cooked/Nucleololu64/README.md

# Nucleololu64
3D printer shield for the STM32 Nucleo 64 board

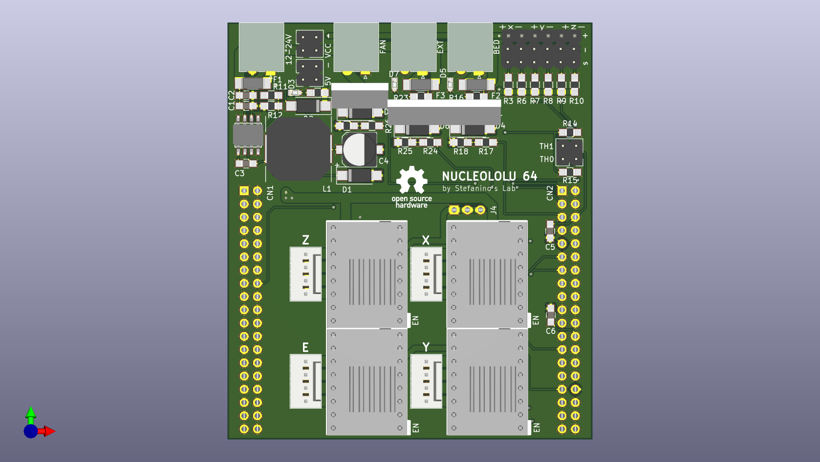
[picture p1: img/Nucleololu64_F.png]
Front
  
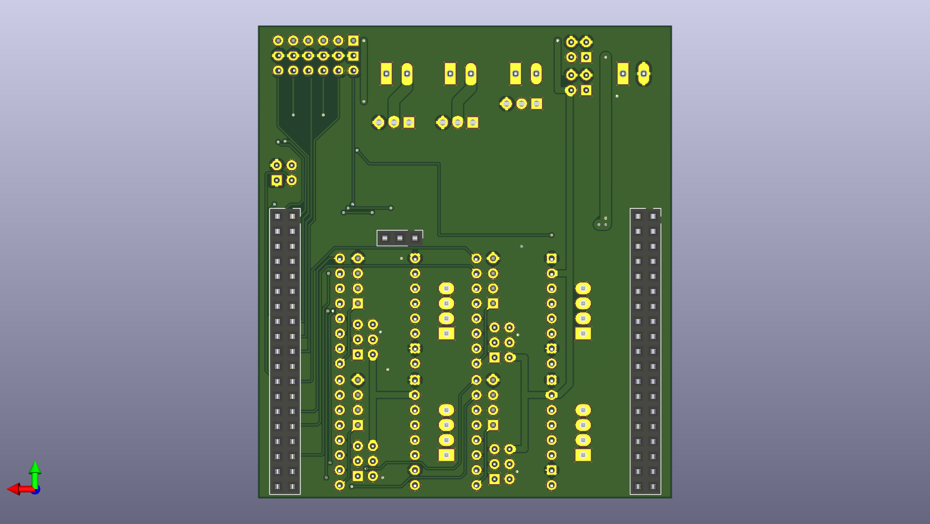
[picture p2: img/Nucleololu64_B.png]
Back
