cooked/Nucleololu64/Footprints/Pololu_Stick_Complete.step

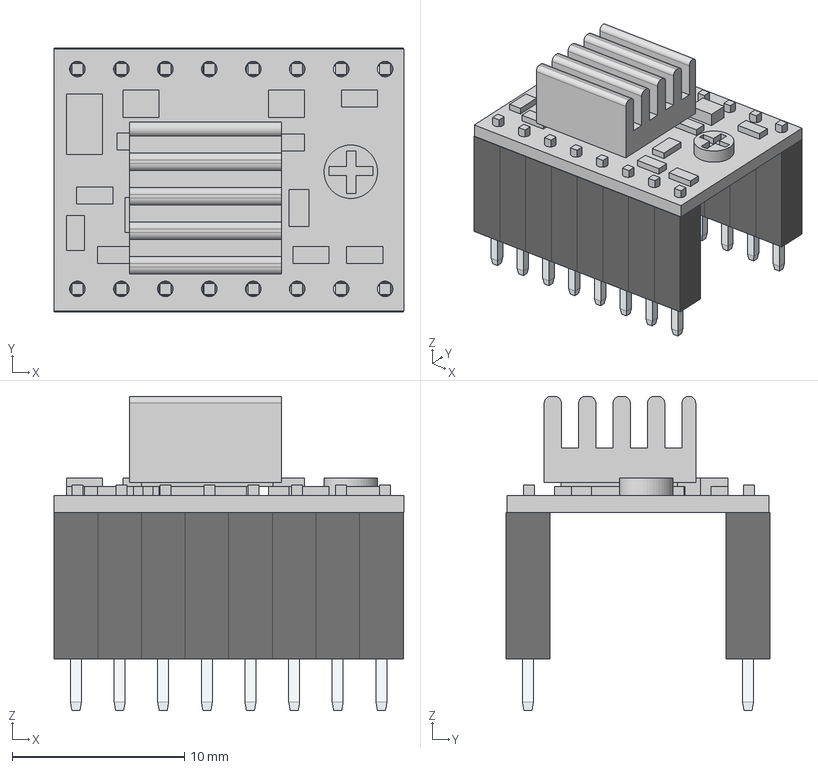
[picture p3: CAD file, 2018-03-17]
Footprints/Pololu_Stick_Complete.step
20.3 x 15.3 x 18.3 mm
Pololu A4899
2.54X8_pinheader_female
2.54X8_pinheader_female v1(Mirror)
