cooked/Nucleololu64/Nucleololu64.kicad_pcb

## KiCad design Nucleololu64.kicad_pcb (2018-03-17)

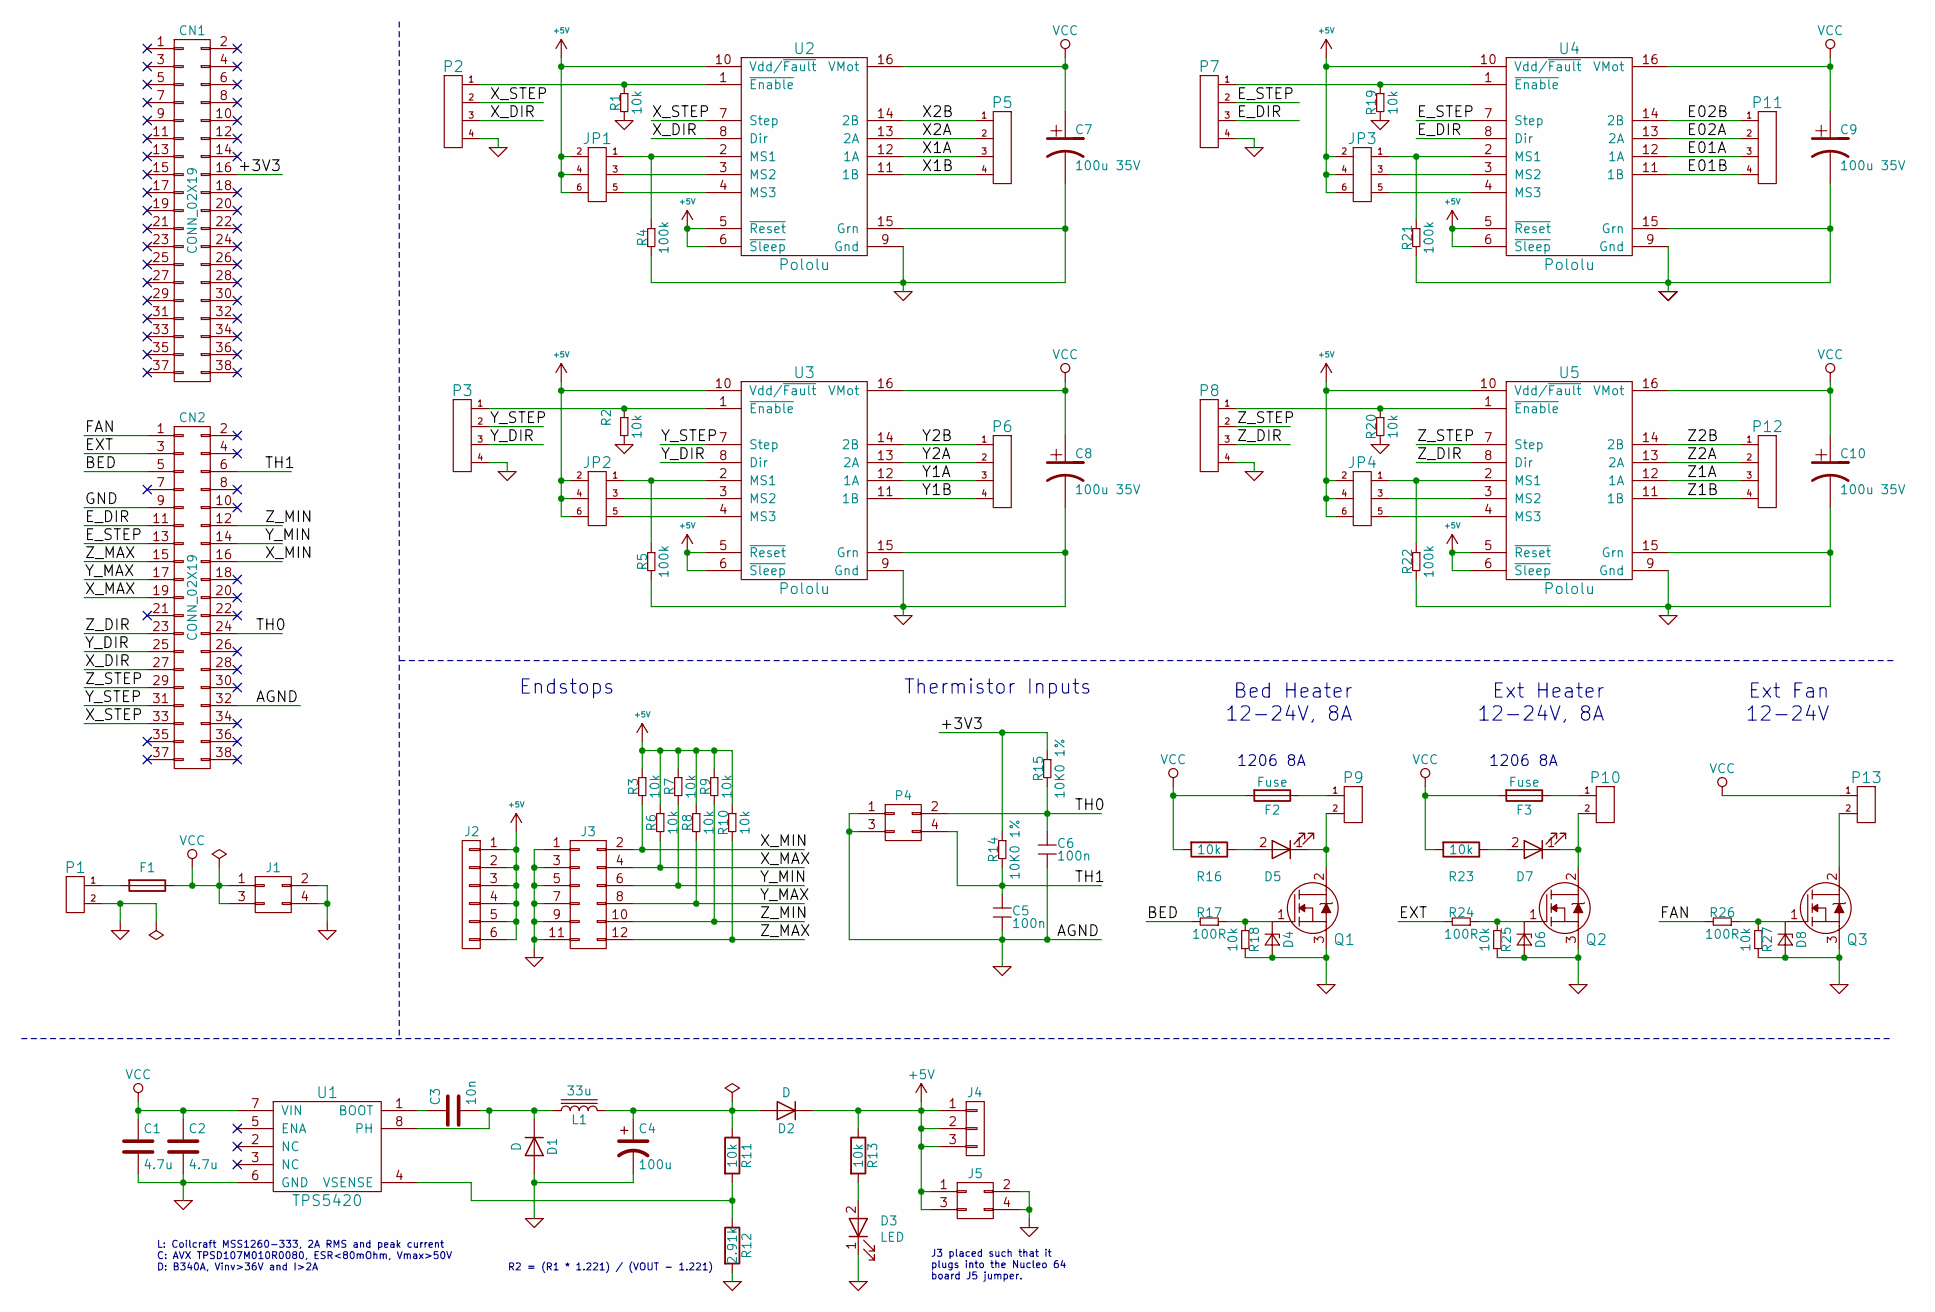
[picture p4: schematic Nucleololu64.sch]

Parts:
C1, C2: 4.7u; C_0805_HandSoldering
C3: 10n; C_0805_HandSoldering
C4: 100u; CP_Elec_6.3x7.7
C5, C6: 100n; C_0805_HandSoldering; PartNo GRM188R71C104KA01D
C7, C8, C9, C10: 100u 35V; CP_Elec_6.3x7.7
CN1, CN2: CONN_02X19; Socket_Strip_Straight_2x19_Pitch2.54mm
D1, D2: D; D_SMA_Handsoldering
D3, D5, D7: LED; LED_0603
D4, D6, D8: D_Zener_Small; D_SMA_Handsoldering
F1, F2, F3: Fuse; Fuse_SMD1206_HandSoldering
J1, J5: CONN_02X02; Pin_Header_Straight_2x02_Pitch2.54mm
J2: CONN_01X06; Pin_Header_Straight_1x06_Pitch2.54mm
J3: CONN_02X06; Pin_Header_Straight_2x06_Pitch2.54mm
J4: CONN_01X03; Socket_Strip_Straight_1x03_Pitch2.54mm
JP1, JP2, JP3, JP4: HEADER_3X2; Pin_Header_Straight_2x03_Pitch2.54mm
L1: 33u; L_12x12mm_h6mm
P1: PT_2,5-2-5,0-H; PhoenixContact_MC-G_02x3.50mm_Angled
P2, P3, P7, P8: KK-2.54-4W; Pin_Header_Straight_1x04_Pitch2.54mm; PartNo 22-23-2041
P4: CONN_02X02; Pin_Header_Straight_2x02_Pitch2.54mm
P5, P6, P11, P12: KK-2.54-4W; Molex_KK-6410-04_04x2.54mm_Straight
P9, P10: PT_2,5-2-5,0-H; PhoenixContact_MC-G_02x3.50mm_Angled; PartNo 1935776
P13: PT_1,5-2-3,5-H; PhoenixContact_MC-G_02x3.50mm_Angled; PartNo 1984617
Q1, Q2, Q3: IRLB8743PBF; TO-220-3_Vertical
R1, R3, R6, R7, R8, R10, R11, R13, R16, R19, R20, R23: 10k; R_0805_HandSoldering
R2: 10k; R_0805_HandSoldering; PartNo RMCF0603FT100K
R4, R5, R21, R22: 100k; R_0805_HandSoldering
R9: 10k; R_0805_HandSoldering; PartNo RMCF0603FT10K0
R12: 2.91k; R_0805_HandSoldering
R14, R15: 10K0 1%; R_0805_HandSoldering
R17, R24, R26: 100R; R_0805_HandSoldering; PartNo RMCF0603FT220R
R18, R25, R27: 10k; R_0805_HandSoldering; PartNo RMCF0603FT220R
U1: TPS5420; SOIC-8-N
U2: Pololu; Pololu_socket
U3, U4, U5: Pololu; Pololu_socket; PartNo DRV8825

Connections:
+5V: D2.1 (K), J2.1, J2.2, J2.3, J2.4, J2.5, J2.6, J4.1, J4.2, J4.3, J5.1, J5.3, JP1.2, JP1.4, JP1.6, JP2.2, JP2.4, JP2.6, JP3.2, JP3.4, JP3.6, JP4.2, JP4.4, JP4.6, R3.1, R6.1, R7.1, R8.1, R9.1, R10.1, R13.1, U2.5 (~Reset), U2.6 (~Sleep), U2.10 (Vdd/~Fault), U3.5 (~Reset), U3.6 (~Sleep), U3.10 (Vdd/~Fault), U4.5 (~Reset), U4.6 (~Sleep), U4.10 (Vdd/~Fault), U5.5 (~Reset), U5.6 (~Sleep), U5.10 (Vdd/~Fault); also elsewhere on the board
/+3V3: CN1.16, R14.1, R15.1
/BED: CN2.5, R17.2
/E01A: P11.3, U4.12 (1A)
/E01B: P11.4, U4.11 (1B)
/E02A: P11.2, U4.13 (2A)
/E02B: P11.1, U4.14 (2B)
/EXT: CN2.3, R24.2
/E_DIR: CN2.11, P7.3, U4.8 (Dir)
/E_STEP: CN2.13, P7.2, U4.7 (Step)
/FAN: CN2.1, R26.2
/TH0: C6.1, CN2.24, P4.2, R15.2
/TH1: C5.1, CN2.6, P4.4, R14.2
/X1A: P5.3, U2.12 (1A)
/X1B: P5.4, U2.11 (1B)
/X2A: P5.2, U2.13 (2A)
/X2B: P5.1, U2.14 (2B)
/X_DIR: CN2.27, P2.3, U2.8 (Dir)
/X_MAX: CN2.19, J3.4, R6.2
/X_MIN: CN2.16, J3.2, R3.2
/X_STEP: CN2.33, P2.2, U2.7 (Step)
/Y1A: P6.3, U3.12 (1A)
/Y1B: P6.4, U3.11 (1B)
/Y2A: P6.2, U3.13 (2A)
/Y2B: P6.1, U3.14 (2B)
/Y_DIR: CN2.25, P3.3, U3.8 (Dir)
/Y_MAX: CN2.17, J3.8, R8.2
/Y_MIN: CN2.14, J3.6, R7.2
/Y_STEP: CN2.31, P3.2, U3.7 (Step)
/Z1A: P12.3, U5.12 (1A)
/Z1B: P12.4, U5.11 (1B)
/Z2A: P12.2, U5.13 (2A)
/Z2B: P12.1, U5.14 (2B)
/Z_DIR: CN2.23, P8.3, U5.8 (Dir)
/Z_MAX: CN2.15, J3.12, R10.2
/Z_MIN: CN2.12, J3.10, R9.2
/Z_STEP: CN2.29, P8.2, U5.7 (Step)
GND: C1.2, C2.2, C4.2, C5.2, C6.2, C7.2, C8.2, C9.2, C10.2, CN2.9, CN2.32, D1.2 (A), D3.1 (K), D4.2 (A), D6.2 (A), D8.2 (A), J1.2, J1.4, J3.1, J3.3, J3.5, J3.7, J3.9, J3.11, J5.2, J5.4, P1.2, P2.4, P3.4, P4.1, P4.3, P7.4, P8.4, Q1.3, Q2.3, Q3.3, R1.2, R2.2, R4.2, R5.2, R12.2, R18.1, R19.2, R20.2, R21.2, R22.2, R25.1, R27.1, U1.6 (GND), U2.9 (Gnd), U2.15 (Grn), U3.9 (Gnd), U3.15 (Grn), U4.9 (Gnd), U4.15 (Grn), U5.9 (Gnd), U5.15 (Grn); also elsewhere on the board
unnamed: C3.1, U1.1 (BOOT)
unnamed: C3.2, D1.1 (K), L1.1, U1.8 (PH)
unnamed: C4.1, D2.2 (A), L1.2, R11.1
unnamed: D3.2 (A), R13.2
unnamed: D4.1 (K), Q1.1, R17.1, R18.2
unnamed 43: D5.1 (K), P9.2, Q1.2; also elsewhere on the board
unnamed: D5.2 (A), R16.1
unnamed: D6.1 (K), Q2.1, R24.1, R25.2
unnamed 46: D7.1 (K), P10.2, Q2.2; also elsewhere on the board
unnamed: D7.2 (A), R23.1
unnamed: D8.1 (K), Q3.1, R26.1, R27.2
unnamed 49: F1.2, P1.1; also elsewhere on the board
unnamed 50: F2.1, P9.1; also elsewhere on the board
unnamed 51: F3.1, P10.1; also elsewhere on the board
unnamed: JP1.1, R4.1, U2.2 (MS1)
unnamed: JP1.3, U2.3 (MS2)
unnamed: JP1.5, U2.4 (MS3)
unnamed: JP2.1, R5.1, U3.2 (MS1)
unnamed: JP2.3, U3.3 (MS2)
unnamed: JP2.5, U3.4 (MS3)
unnamed: JP3.1, R21.1, U4.2 (MS1)
unnamed: JP3.3, U4.3 (MS2)
unnamed: JP3.5, U4.4 (MS3)
unnamed: JP4.1, R22.1, U5.2 (MS1)
unnamed: JP4.3, U5.3 (MS2)
unnamed: JP4.5, U5.4 (MS3)
unnamed: P2.1, R1.1, U2.1 (~Enable)
unnamed: P3.1, R2.1, U3.1 (~Enable)
unnamed: P7.1, R19.1, U4.1 (~Enable)
unnamed: P8.1, R20.1, U5.1 (~Enable)
unnamed 68: P13.2, Q3.2; also elsewhere on the board
unnamed: R11.2, R12.1, U1.4 (VSENSE)
VCC: C1.1, C2.1, C7.1, C8.1, C9.1, C10.1, F1.1, F2.2, F3.2, J1.1, J1.3, P13.1, R16.2, R23.2, U1.7 (VIN), U2.16 (VMot), U3.16 (VMot), U4.16 (VMot), U5.16 (VMot); also elsewhere on the board

Notes on the sheet:
Endstops
Thermistor Inputs
Ext Heater 12-24V, 8A
Ext Fan 12-24V
1206 8A
R2 = (R1 * 1.221) / (VOUT - 1.221)
L: Coilcraft MSS1260-333, 2A RMS and peak current C: AVX TPSD107M010R0080, ESR<80mOhm, Vmax>50V D: B340A, Vinv>36V and I>2A
Bed Heater 12-24V, 8A
J3 placed such that it plugs into the Nucleo 64 board J5 jumper.

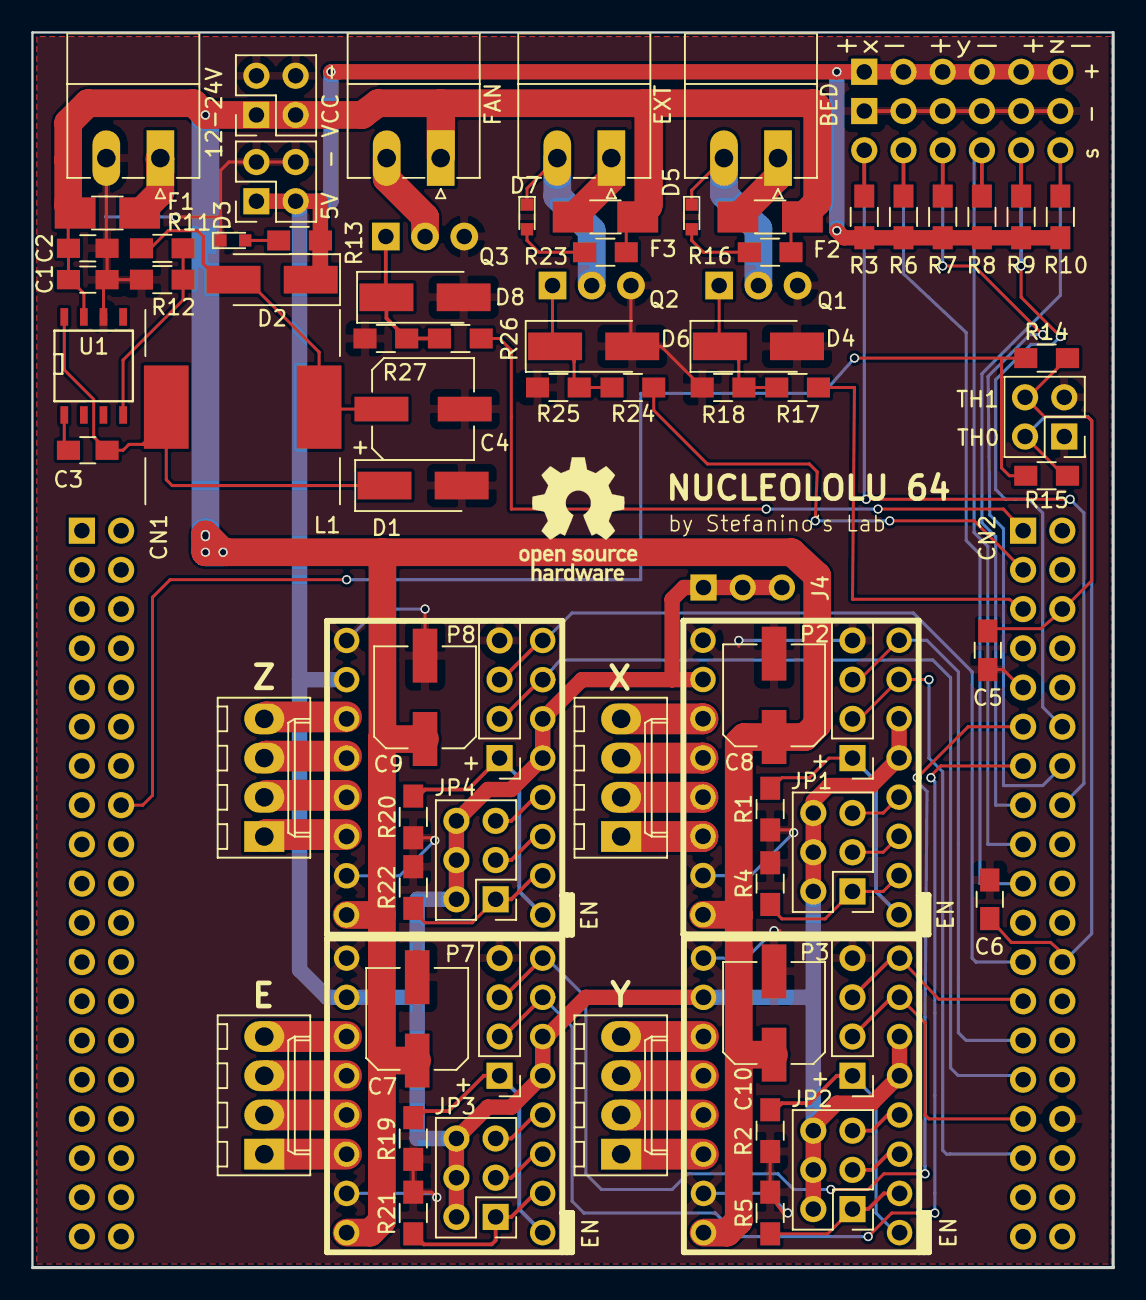
[picture p5: board Nucleololu64.kicad_pcb from above]

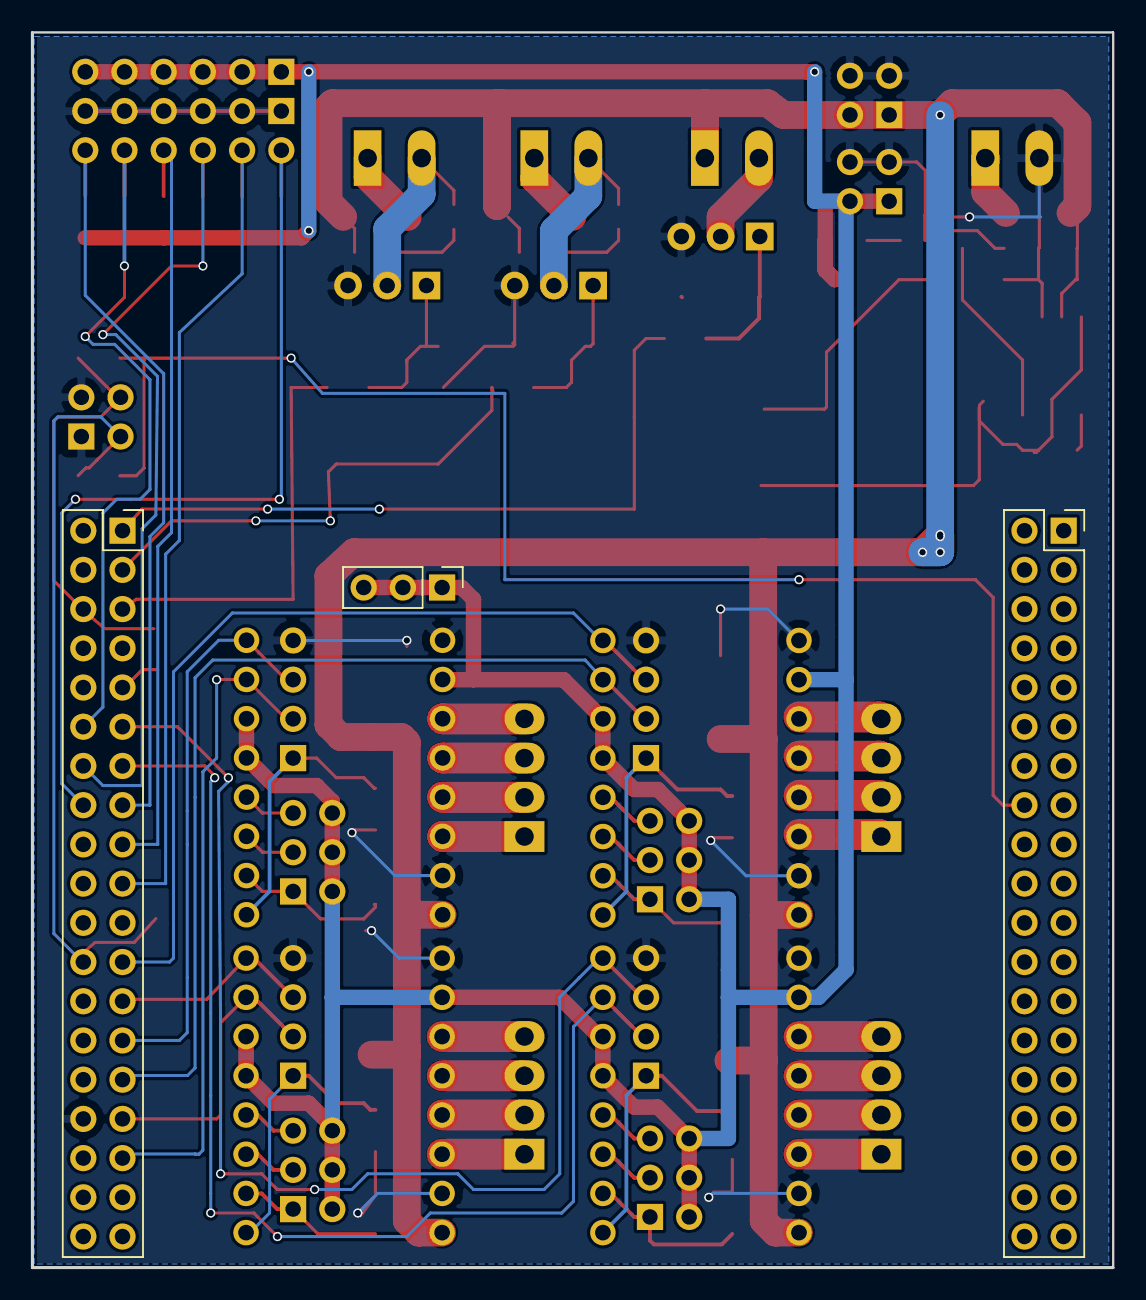
[picture p6: board Nucleololu64.kicad_pcb from below]

Board: 2 copper layers, 70.0 x 80.0 mm, 81 parts (4 on the bottom side), 71 nets.

Other parts of the board:
5V  -: CONN_02X02; Pin_Header_Straight_2x02_Pitch2.54mm
12-24V: PT_2,5-2-5,0-H; PhoenixContact_MC-G_02x3.50mm_Angled
BED: PT_2,5-2-5,0-H; PhoenixContact_MC-G_02x3.50mm_Angled
EXT: PT_2,5-2-5,0-H; PhoenixContact_MC-G_02x3.50mm_Angled
FAN: PT_1,5-2-3,5-H; PhoenixContact_MC-G_02x3.50mm_Angled
VCC -: CONN_02X02; Pin_Header_Straight_2x02_Pitch2.54mm

Their connections:
+5V: 5V -.1, 5V -.3; also elsewhere on the board
GND: 5V -.2, 5V -.4, 12-24V.2, VCC -.2, VCC -.4; also elsewhere on the board
unnamed 43: BED.2; also elsewhere on the board
unnamed 46: EXT.2; also elsewhere on the board
unnamed 49: 12-24V.1; also elsewhere on the board
unnamed 50: BED.1; also elsewhere on the board
unnamed 51: EXT.1; also elsewhere on the board
unnamed 68: FAN.2; also elsewhere on the board
VCC: FAN.1, VCC -.1, VCC -.3; also elsewhere on the board
