cooked/Nucleololu64/(threads)

Thread 1 (2018-03-24):

add Enable signal from controller

cooked, 2018-03-24:
currently the stepstick drivers are always enabled via 10k resistor to GND. An Enable signal from the controller should be implemented too

Thread 2 (2018-03-27):

fix power merger J4

cooked, 2018-03-27:
- split central pin e U5V (USB power supply) on J4. Insert the ideal diode to protect USB from Nucleololu 5V power supply

Thread 3 (2018-03-27):

upgrade power supply section

cooked, 2018-03-27:
- the DC/DC is not necessary since the Nucleo has a VIN pin. Add a jumper or something to allow the use of the regulator onboard the Nucleo
