cooked/Nucleololu64/(commit log)

2018-03-10 uploaded schematics
    [Nucleololu64.sch]
2018-03-16 batch commit rev.1
    [Nucleololu64-B.Cu.gbr, Nucleololu64-B.Mask.gbr, Nucleololu64-B.SilkS.gbr, Nucleololu64-Edge.Cuts.gbr, Nucleololu64-F.Cu.gbr, Nucleololu64-F.Mask.gbr, Nucleololu64-F.SilkS.gbr, Nucleololu64-NPTH.drl]
2018-03-17 added many manf#
    [Nucleololu64.kicad_pcb, Nucleololu64.sch]
